vanceb/CarAudio/README.md

# CarAudio
Car Audio Using Raspberry Pi and a DAB Radio board
