vanceb/CarAudio/kicad/VolumeControl.kicad_pcb

## KiCad design kicad/VolumeControl.kicad_pcb (2016-07-01)

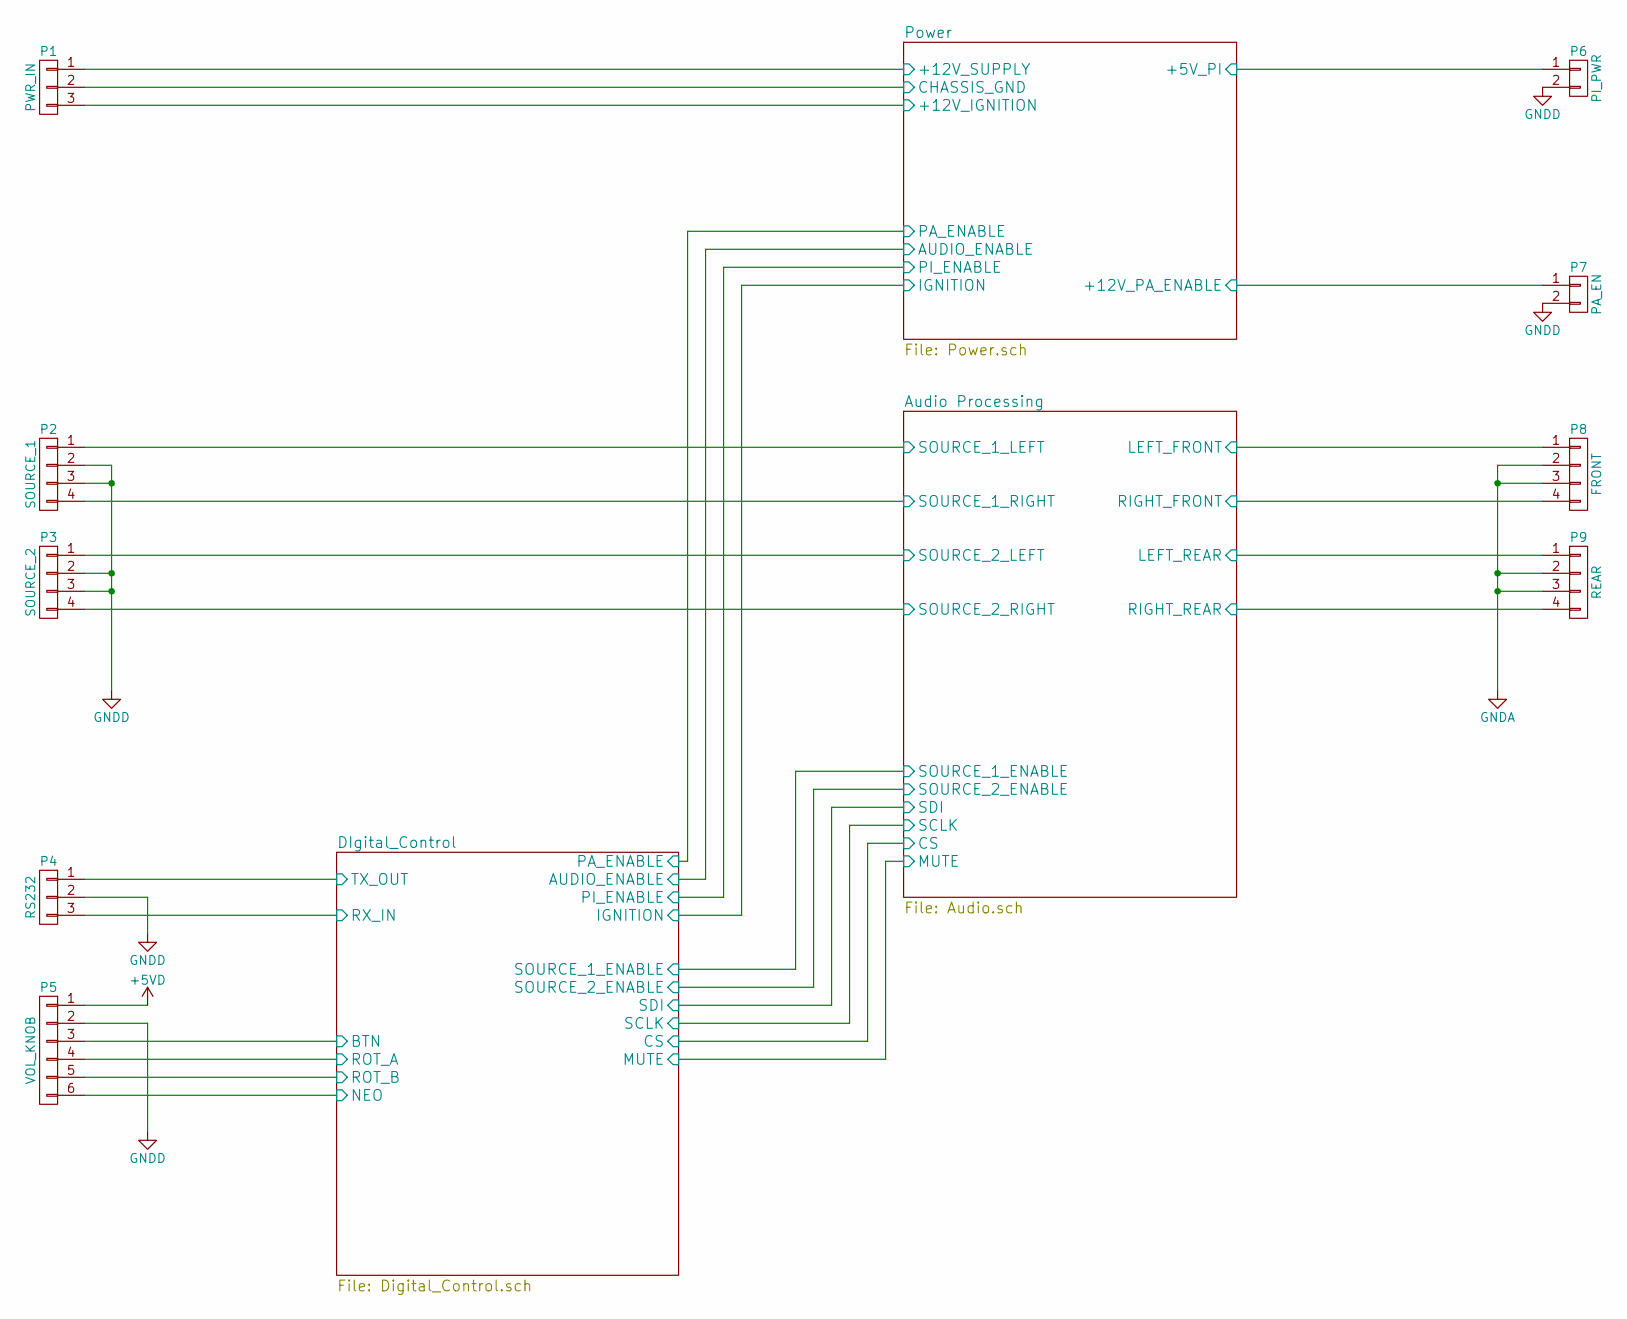
[picture p1: schematic VolumeControl.sch]

Parts:
P1: PWR_IN; JST-3RA
P2: SOURCE_1; JST-4RA
P3: SOURCE_2; JST-4RA
P4: RS232; JST-3RA
P5: VOL_KNOB; JST-6RA
P6: PI_PWR; JST-2RA
P7: PA_EN; JST-2RA
P8: FRONT; JST-4RA
P9: REAR; JST-4RA

Connections:
+5VD: P5.1; also elsewhere on the board
/Audio Processing/LEFT_FRONT: P8.1; also elsewhere on the board
/Audio Processing/LEFT_REAR: P9.1; also elsewhere on the board
/Audio Processing/RIGHT_FRONT: P8.4; also elsewhere on the board
/Audio Processing/RIGHT_REAR: P9.4; also elsewhere on the board
/Audio Processing/SOURCE_1_LEFT: P2.1; also elsewhere on the board
/Audio Processing/SOURCE_1_RIGHT: P2.4; also elsewhere on the board
/Audio Processing/SOURCE_2_LEFT: P3.1; also elsewhere on the board
/Audio Processing/SOURCE_2_RIGHT: P3.4; also elsewhere on the board
/DIgital_Control/BTN: P5.3; also elsewhere on the board
/DIgital_Control/NEO: P5.6; also elsewhere on the board
/DIgital_Control/ROT_A: P5.4; also elsewhere on the board
/DIgital_Control/ROT_B: P5.5; also elsewhere on the board
/DIgital_Control/RX_IN: P4.3; also elsewhere on the board
/DIgital_Control/TX_OUT: P4.1; also elsewhere on the board
/Power/+5V_PI: P6.1; also elsewhere on the board
/Power/+12V_IGNITION: P1.3; also elsewhere on the board
/Power/+12V_PA_ENABLE: P7.1; also elsewhere on the board
/Power/+12V_SUPPLY: P1.1; also elsewhere on the board
GND: P1.2, P2.2, P2.3, P3.2, P3.3, P4.2, P5.2, P6.2, P7.2, P8.2, P8.3, P9.2, P9.3; also elsewhere on the board

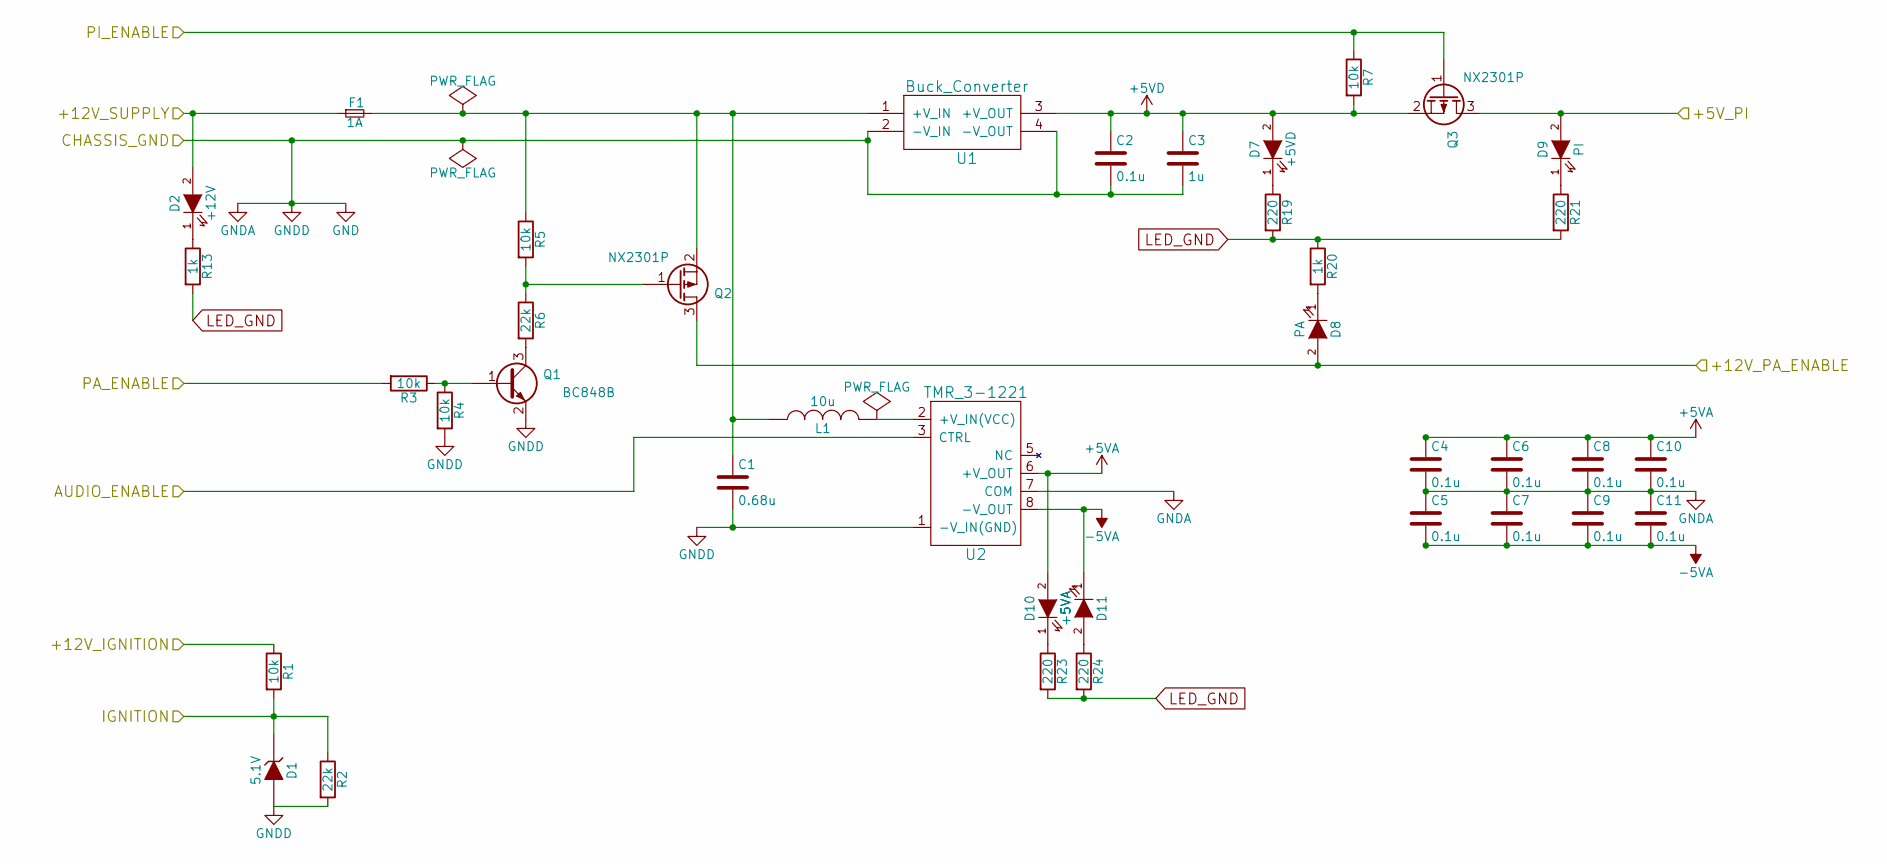
[picture p2: schematic Power.sch]

Parts:
C1: 0.68u; C_1206_HandSoldering
C2, C4, C5, C6, C7, C8, C9, C10, C11: 0.1u; C_0603_HandSoldering
C3: 1u; C_1206_HandSoldering
D1: 5.1V; SOD-123
D2: +12V; LED_SMD_1.6x0.8mm
D7: +5VD; LED_SMD_1.6x0.8mm
D8: PA; LED_SMD_1.6x0.8mm
D9: PI; LED_SMD_1.6x0.8mm
D10: +5VA; LED_SMD_1.6x0.8mm
D11: -5VA; LED_SMD_1.6x0.8mm
F1: 1A; Fuseholder5x20_horiz_SemiClosed_Casing10x25mm
L1: 10u; Inductor_SRR0735A
Q1: BC848B; SOT-23_Handsoldering
Q2, Q3: NX2301P; SOT-23_Handsoldering
R1, R3, R4, R5, R7: 10k; R_0603_HandSoldering
R2, R6: 22k; R_0603_HandSoldering
R13, R20: 1k; R_0603_HandSoldering
R19, R21, R23, R24: 220; R_0603_HandSoldering
U1: Buck_Converter
U2: TMR_3-1221; TMR_3

Connections:
+5VA: C4.1, C6.1, C8.1, C10.1, D10.2 (A), U2.6 (+V_OUT); also elsewhere on the board
+5VD: C2.1, C3.1, D7.2 (A), Q3.2 (S), R7.2, U1.3 (+V_OUT); also elsewhere on the board
-5VA: C5.2, C7.2, C9.2, C11.2, D11.1 (K), U2.8 (-V_OUT); also elsewhere on the board
/DIgital_Control/AUDIO_ENABLE: U2.3 (CTRL); also elsewhere on the board
/DIgital_Control/IGNITION: D1.1 (K), R1.2, R2.1; also elsewhere on the board
/DIgital_Control/PA_ENABLE: R3.2; also elsewhere on the board
/DIgital_Control/PI_ENABLE: Q3.1 (G), R7.1; also elsewhere on the board
/Power/+5V_PI: D9.2 (A), Q3.3 (D); also elsewhere on the board
/Power/+12V_IGNITION: R1.1; also elsewhere on the board
/Power/+12V_PA_ENABLE: D8.2 (A), Q2.3 (D); also elsewhere on the board
/Power/+12V_SUPPLY: D2.2 (A), F1.1; also elsewhere on the board
GND: C1.2, C2.2, C3.2, C4.2, C5.1, C6.2, C7.1, C8.2, C9.1, C10.2, C11.1, D1.2 (A), Q1.2 (E), R2.2, R4.2, U1.2 (-V_IN), U1.4 (-V_OUT), U2.1 (-V_IN(GND)), U2.7 (COM); also elsewhere on the board
LED_GND: R13.2, R19.2, R20.1, R21.2, R23.2, R24.2; also elsewhere on the board
unnamed: C1.1, F1.2, L1.1, Q2.2 (S), R5.1, U1.1 (+V_IN)
unnamed: D2.1 (K), R13.1
unnamed: D7.1 (K), R19.1
unnamed: D8.1 (K), R20.2
unnamed: D9.1 (K), R21.1
unnamed: D10.1 (K), R23.1
unnamed: D11.2 (A), R24.1
unnamed: L1.2, U2.2 (+V_IN(VCC))
unnamed: Q1.1 (B), R3.1, R4.1
unnamed: Q1.3 (C), R6.2
unnamed: Q2.1 (G), R5.2, R6.1

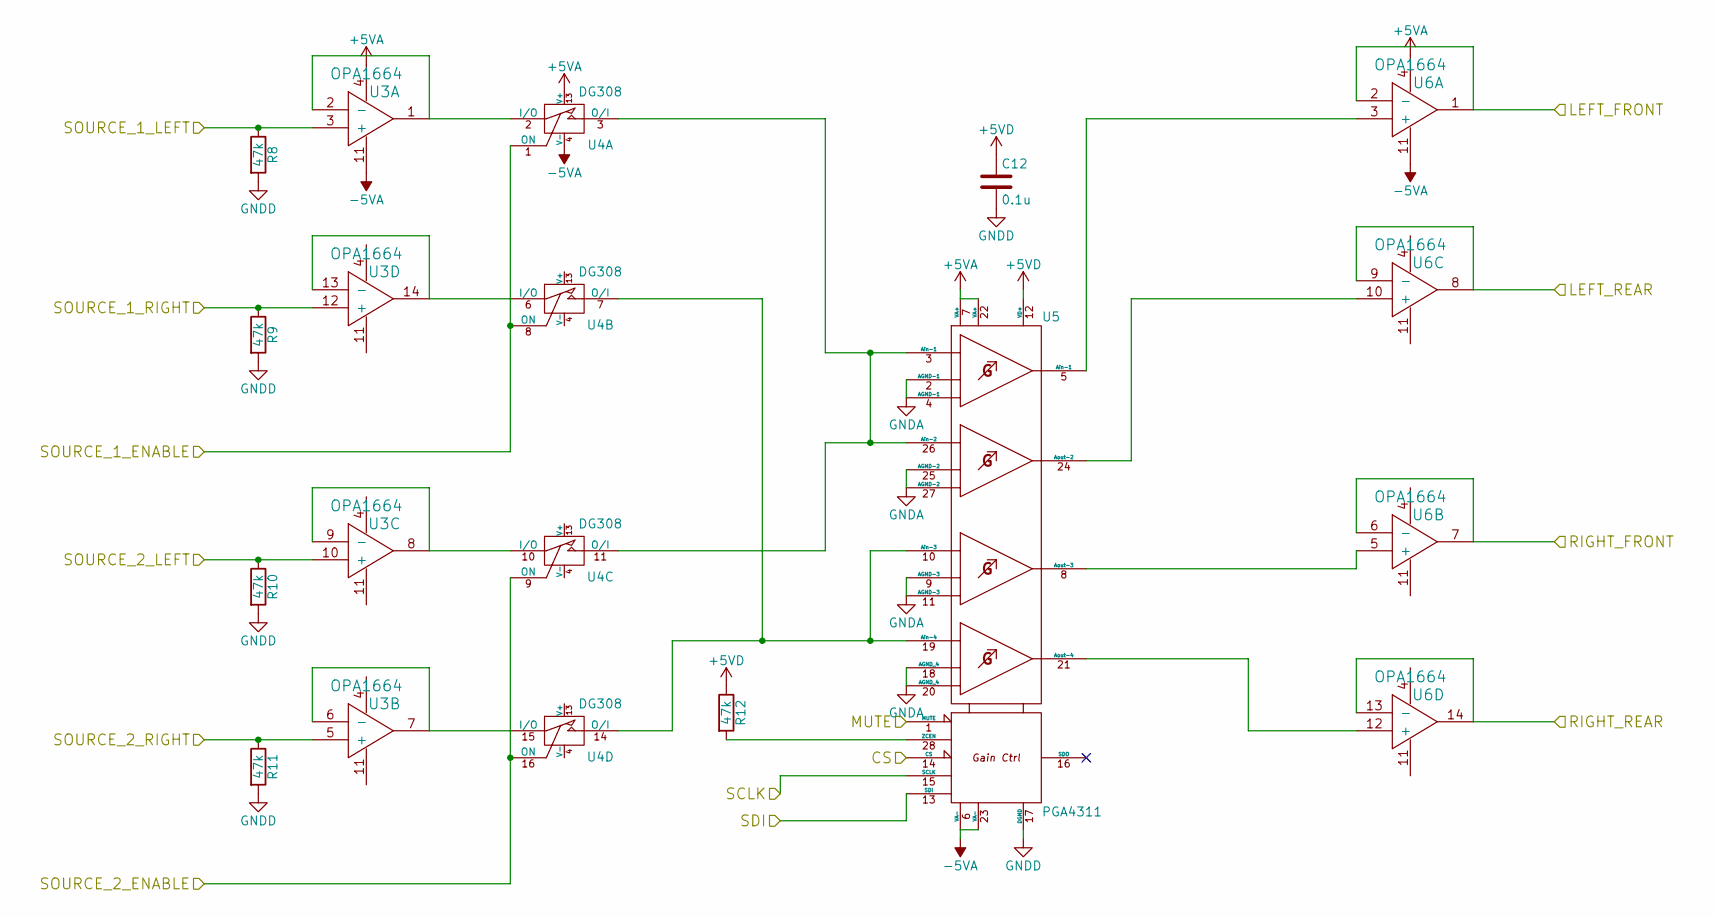
[picture p3: schematic Audio.sch]

Parts:
C12: 0.1u; C_0603_HandSoldering
R8, R9, R10, R11, R12: 47k; R_0603_HandSoldering
U3, U6: OPA1664; SOIC-14_N
U4: DG308; SOIC-16_3.9x9.9mm_Pitch1.27mm
U5: PGA4311; SOIC-28_7.5x17.9mm_Pitch1.27mm

Connections:
+5VA: U3.4, U4.13 (V+), U5.7 (VA+), U5.22 (VA+), U6.4; also elsewhere on the board
+5VD: C12.1, R12.1, U5.12 (VD+); also elsewhere on the board
-5VA: U3.11, U4.4 (V-), U5.6 (VA-), U5.23 (VA-), U6.11; also elsewhere on the board
/Audio Processing/CS: U5.14 (CS); also elsewhere on the board
/Audio Processing/LEFT_FRONT: U6.1, U6.2 (-); also elsewhere on the board
/Audio Processing/LEFT_REAR: U6.8, U6.9 (-); also elsewhere on the board
/Audio Processing/MUTE: U5.1 (MUTE); also elsewhere on the board
/Audio Processing/RIGHT_FRONT: U6.6 (-), U6.7; also elsewhere on the board
/Audio Processing/RIGHT_REAR: U6.13 (-), U6.14; also elsewhere on the board
/Audio Processing/SCLK: U5.15 (SCLK); also elsewhere on the board
/Audio Processing/SDI: U5.13 (SDI); also elsewhere on the board
/Audio Processing/SOURCE_1_ENABLE: U4.1 (ON), U4.8 (ON); also elsewhere on the board
/Audio Processing/SOURCE_1_LEFT: R8.1, U3.3 (+); also elsewhere on the board
/Audio Processing/SOURCE_1_RIGHT: R9.1, U3.12 (+); also elsewhere on the board
/Audio Processing/SOURCE_2_ENABLE: U4.9 (ON), U4.16 (ON); also elsewhere on the board
/Audio Processing/SOURCE_2_LEFT: R10.1, U3.10 (+); also elsewhere on the board
/Audio Processing/SOURCE_2_RIGHT: R11.1, U3.5 (+); also elsewhere on the board
GND: C12.2, R8.2, R9.2, R10.2, R11.2, U4.5 (GND), U5.2 (AGND-1), U5.4 (AGND-1), U5.9 (AGND-3), U5.11 (AGND-3), U5.17 (DGND), U5.18 (AGND_4), U5.20 (AGND_4), U5.25 (AGND-2), U5.27 (AGND-2); also elsewhere on the board
unnamed: R12.2, U5.28 (ZCEN)
unnamed: U3.1, U3.2 (-), U4.2 (I/O)
unnamed: U3.6 (-), U3.7, U4.15 (I/O)
unnamed: U3.8, U3.9 (-), U4.10 (I/O)
unnamed: U3.13 (-), U3.14, U4.6 (I/O)
unnamed: U4.3 (O/I), U4.11 (O/I), U5.3 (Ain-1), U5.26 (Ain-2)
unnamed: U4.7 (O/I), U4.14 (O/I), U5.10 (Ain-3), U5.19 (Ain-4)
unnamed: U5.5 (Ain-1), U6.3 (+)
unnamed: U5.8 (Aout-3), U6.5 (+)
unnamed: U5.21 (Aout-4), U6.12 (+)
unnamed: U5.24 (Aout-2), U6.10 (+)

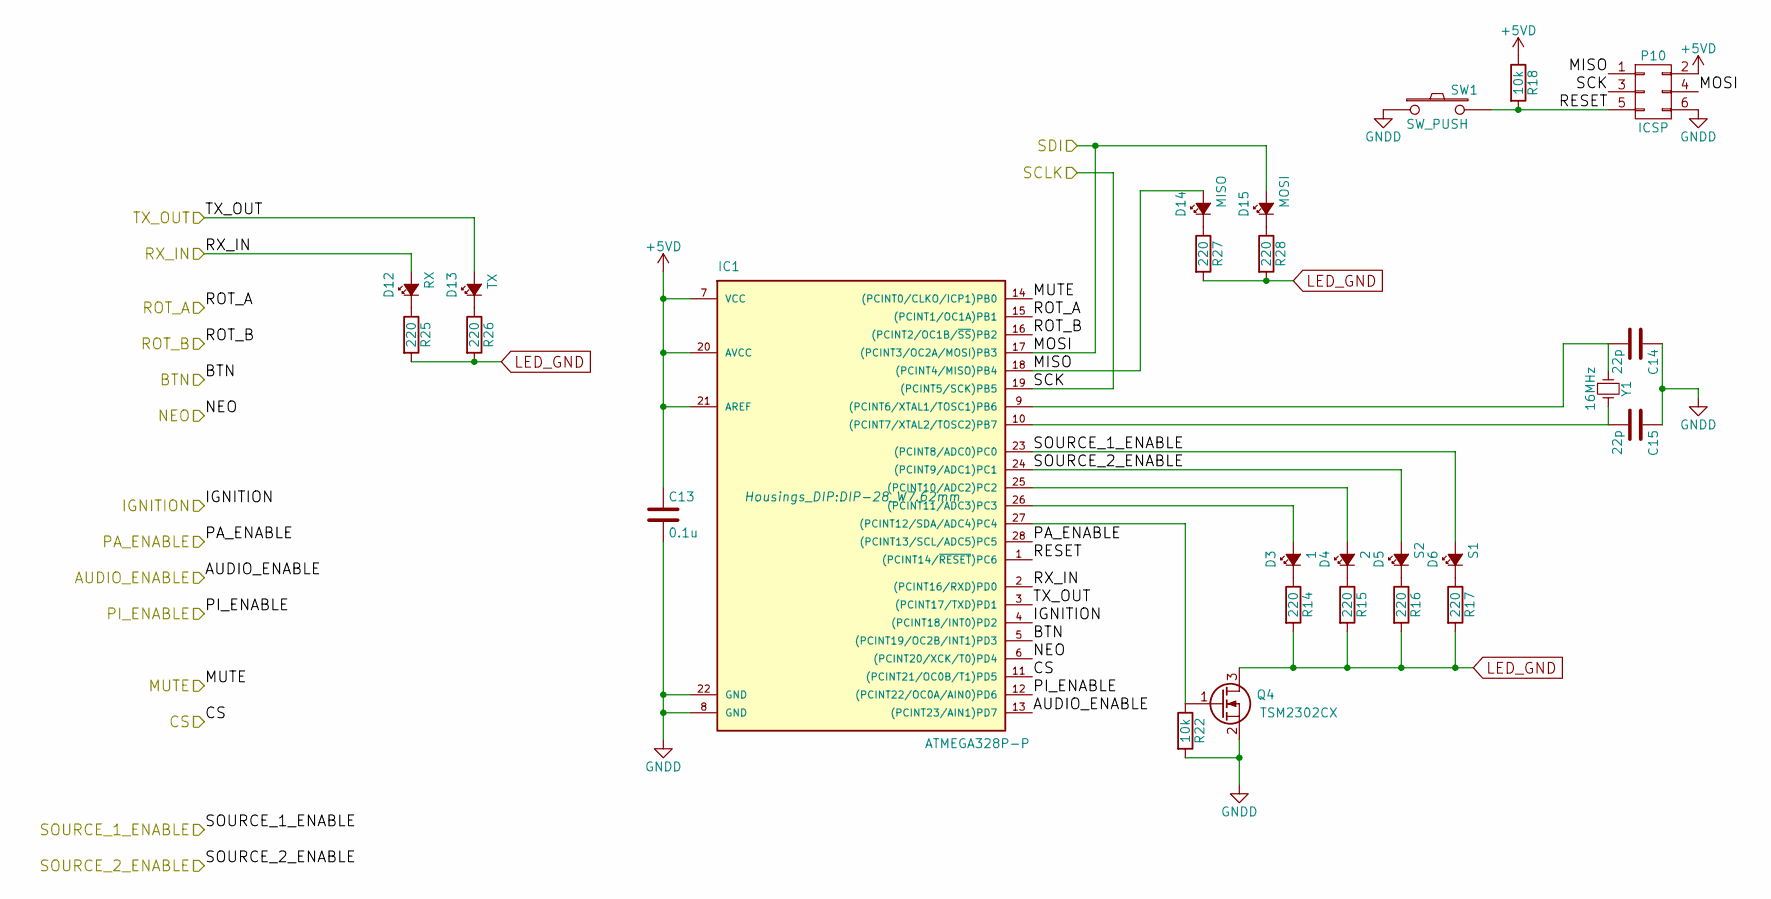
[picture p4: schematic Digital_Control.sch]

Parts:
C13: 0.1u; C_0603_HandSoldering
C14, C15: 22p; C_0603_HandSoldering
D3: 1; LED_SMD_1.6x0.8mm
D4: 2; LED_SMD_1.6x0.8mm
D5: S2; LED_SMD_1.6x0.8mm
D6: S1; LED_SMD_1.6x0.8mm
D12: RX; LED_SMD_1.6x0.8mm
D13: TX; LED_SMD_1.6x0.8mm
D14: MISO; LED_SMD_1.6x0.8mm
D15: MOSI; LED_SMD_1.6x0.8mm
IC1: ATMEGA328P-P; DIP-28_W7.62mm
P10: ICSP; Pin_Header_Straight_2x03
Q4: TSM2302CX; SOT-23_Handsoldering
R14, R15, R16, R17, R25, R26, R27, R28: 220; R_0603_HandSoldering
R18, R22: 10k; R_0603_HandSoldering
SW1: SW_PUSH; SW_SPST_EVPBF
Y1: 16MHz; Crystal_HC49-U_Vertical

Connections:
+5VD: C13.1, IC1.7 (VCC), IC1.20 (AVCC), IC1.21 (AREF), P10.2, R18.1; also elsewhere on the board
/Audio Processing/CS: IC1.11 ((PCINT21/OC0B/T1)PD5); also elsewhere on the board
/Audio Processing/MUTE: IC1.14 ((PCINT0/CLKO/ICP1)PB0); also elsewhere on the board
/Audio Processing/SCLK: IC1.19 ((PCINT5/SCK)PB5), P10.3; also elsewhere on the board
/Audio Processing/SDI: D15.2 (A), IC1.17 ((PCINT3/OC2A/MOSI)PB3), P10.4; also elsewhere on the board
/Audio Processing/SOURCE_1_ENABLE: D6.2 (A), IC1.23 ((PCINT8/ADC0)PC0); also elsewhere on the board
/Audio Processing/SOURCE_2_ENABLE: D5.2 (A), IC1.24 ((PCINT9/ADC1)PC1); also elsewhere on the board
/DIgital_Control/AUDIO_ENABLE: IC1.13 ((PCINT23/AIN1)PD7); also elsewhere on the board
/DIgital_Control/BTN: IC1.5 ((PCINT19/OC2B/INT1)PD3); also elsewhere on the board
/DIgital_Control/IGNITION: IC1.4 ((PCINT18/INT0)PD2); also elsewhere on the board
/DIgital_Control/MISO: D14.2 (A), IC1.18 ((PCINT4/MISO)PB4), P10.1
/DIgital_Control/NEO: IC1.6 ((PCINT20/XCK/T0)PD4); also elsewhere on the board
/DIgital_Control/PA_ENABLE: IC1.28 ((PCINT13/SCL/ADC5)PC5); also elsewhere on the board
/DIgital_Control/PI_ENABLE: IC1.12 ((PCINT22/OC0A/AIN0)PD6); also elsewhere on the board
/DIgital_Control/RESET: IC1.1 ((PCINT14/~RESET~)PC6), P10.5, R18.2, SW1.2
/DIgital_Control/ROT_A: IC1.15 ((PCINT1/OC1A)PB1); also elsewhere on the board
/DIgital_Control/ROT_B: IC1.16 ((PCINT2/OC1B/~SS~)PB2); also elsewhere on the board
/DIgital_Control/RX_IN: D12.2 (A), IC1.2 ((PCINT16/RXD)PD0); also elsewhere on the board
/DIgital_Control/TX_OUT: D13.2 (A), IC1.3 ((PCINT17/TXD)PD1); also elsewhere on the board
GND: C13.2, C14.1, C15.1, IC1.8 (GND), IC1.22 (GND), P10.6, Q4.2 (S), R22.2, SW1.1; also elsewhere on the board
LED_GND: Q4.3 (D), R14.2, R15.2, R16.2, R17.2, R25.2, R26.2, R27.2, R28.2; also elsewhere on the board
unnamed: C14.2, IC1.9 ((PCINT6/XTAL1/TOSC1)PB6), Y1.1
unnamed: C15.2, IC1.10 ((PCINT7/XTAL2/TOSC2)PB7), Y1.2
unnamed: D3.1 (K), R14.1
unnamed: D3.2 (A), IC1.26 ((PCINT11/ADC3)PC3)
unnamed: D4.1 (K), R15.1
unnamed: D4.2 (A), IC1.25 ((PCINT10/ADC2)PC2)
unnamed: D5.1 (K), R16.1
unnamed: D6.1 (K), R17.1
unnamed: D12.1 (K), R25.1
unnamed: D13.1 (K), R26.1
unnamed: D14.1 (K), R27.1
unnamed: D15.1 (K), R28.1
unnamed: IC1.27 ((PCINT12/SDA/ADC4)PC4), Q4.1 (G), R22.1

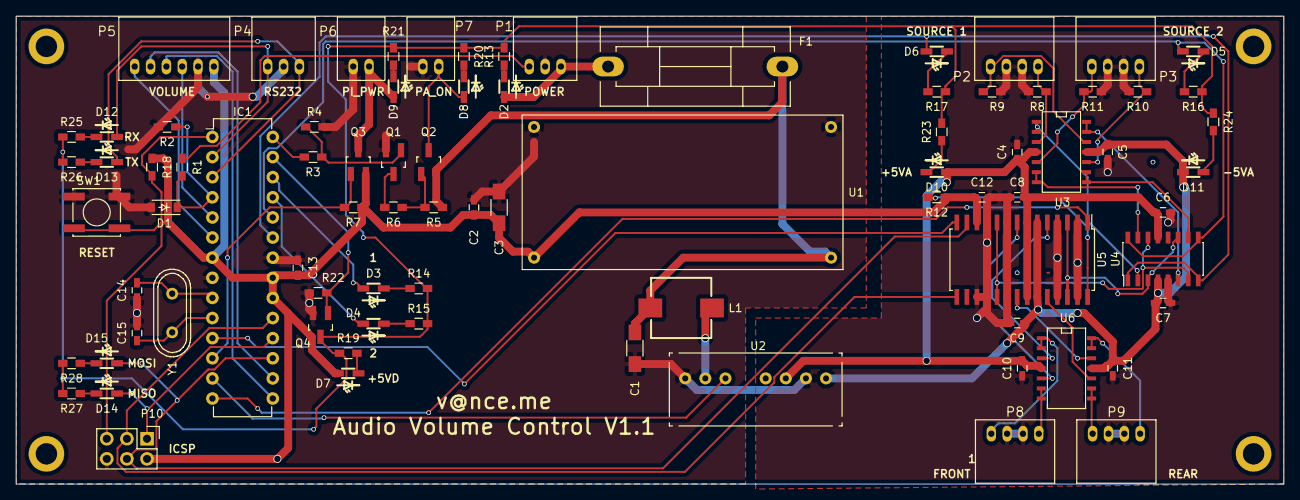
[picture p5: board VolumeControl.kicad_pcb from above]

Board: 2 copper layers, 160.0 x 59.1 mm, 83 parts (0 on the bottom side), 70 nets.
