vanceb/CarAudio/kicad/VolKnob/VolKnob.kicad_pcb

## KiCad design kicad/VolKnob/VolKnob.kicad_pcb (2016-06-23)

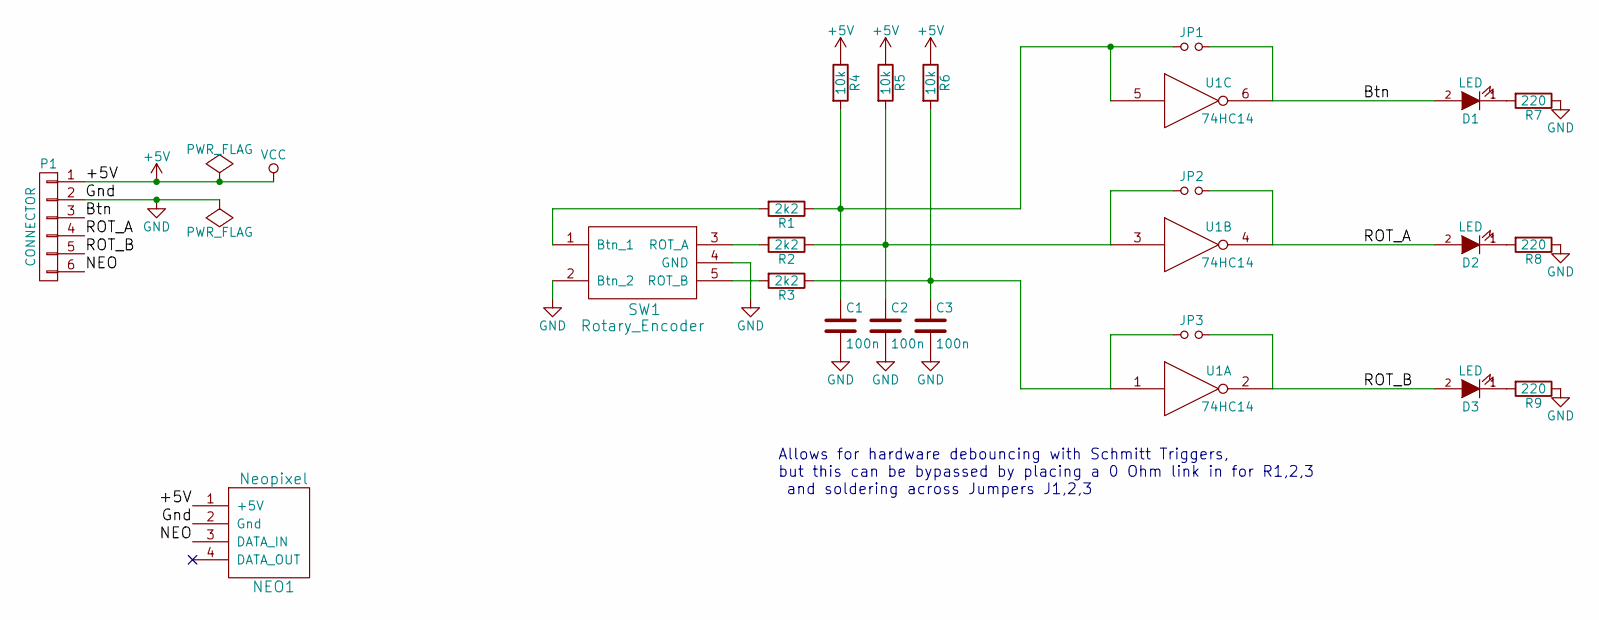
[picture p6: schematic VolKnob.sch]

Parts:
C1, C2, C3: 100n; C_0603_HandSoldering
D1, D2, D3: LED; LED_SMD_1.6x0.8mm
JP1, JP2, JP3: Jumper_NO_Small; Jumper_NO
NEO1: Neopixel; NeoPixel_Ring_12
P1: CONNECTOR; JST-6RA
R1, R2, R3: 2k2; R_0603_HandSoldering
R4, R5, R6: 10k; R_0603_HandSoldering
R7, R8, R9: 220; R_0603_HandSoldering
SW1: Rotary_Encoder
U1: 74HC14; SOIC-14_N

Connections:
+5V: NEO1.1 (+5V), P1.1, R4.1, R5.1, R6.1, U1.14 (VCC)
/Btn: D1.2 (A), JP1.2, P1.3, U1.6
/NEO: NEO1.3 (DATA_IN), P1.6
/ROT_A: D2.2 (A), JP2.2, P1.4, U1.4
/ROT_B: D3.2 (A), JP3.2, P1.5, U1.2
GND: C1.2, C2.2, C3.2, NEO1.2 (Gnd), P1.2, R7.1, R8.1, R9.1, SW1.2 (Btn_2), SW1.4 (GND), U1.7 (GND)
unnamed: C1.1, JP1.1, R1.1, R4.2, U1.5
unnamed: C2.1, JP2.1, R2.1, R5.2, U1.3
unnamed: C3.1, JP3.1, R3.1, R6.2, U1.1
unnamed: D1.1 (K), R7.2
unnamed: D2.1 (K), R8.2
unnamed: D3.1 (K), R9.2
unnamed: R1.2, SW1.1 (Btn_1)
unnamed: R2.2, SW1.3 (ROT_A)
unnamed: R3.2, SW1.5 (ROT_B)

Notes on the sheet:
Allows for hardware debouncing with Schmitt Triggers, but this can be bypassed by placing a 0 Ohm link in for R1,2,3 and soldering across Jumpers J1,2,3

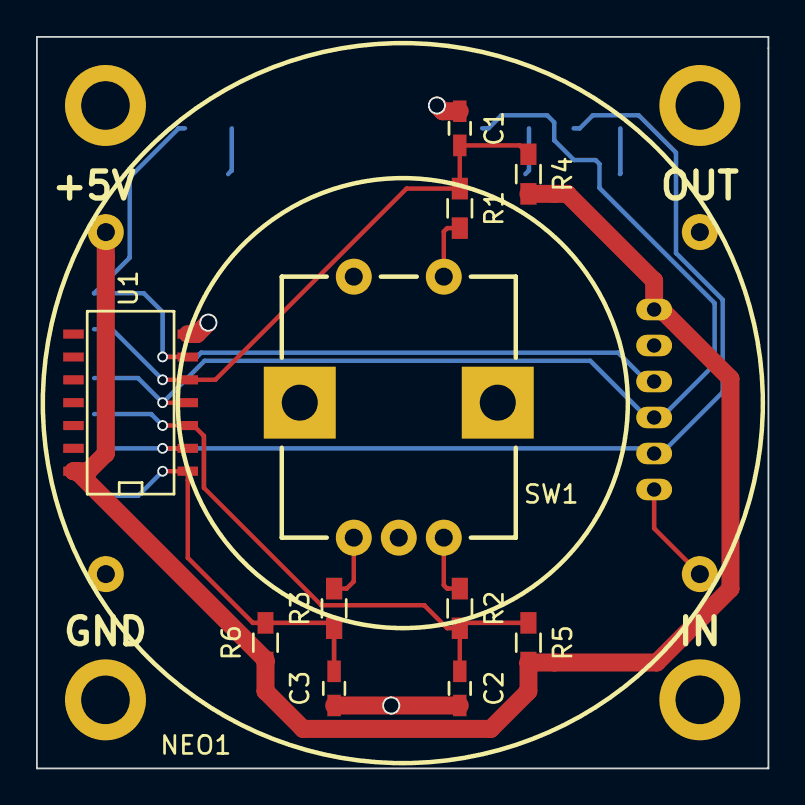
[picture p7: board VolKnob.kicad_pcb from above]

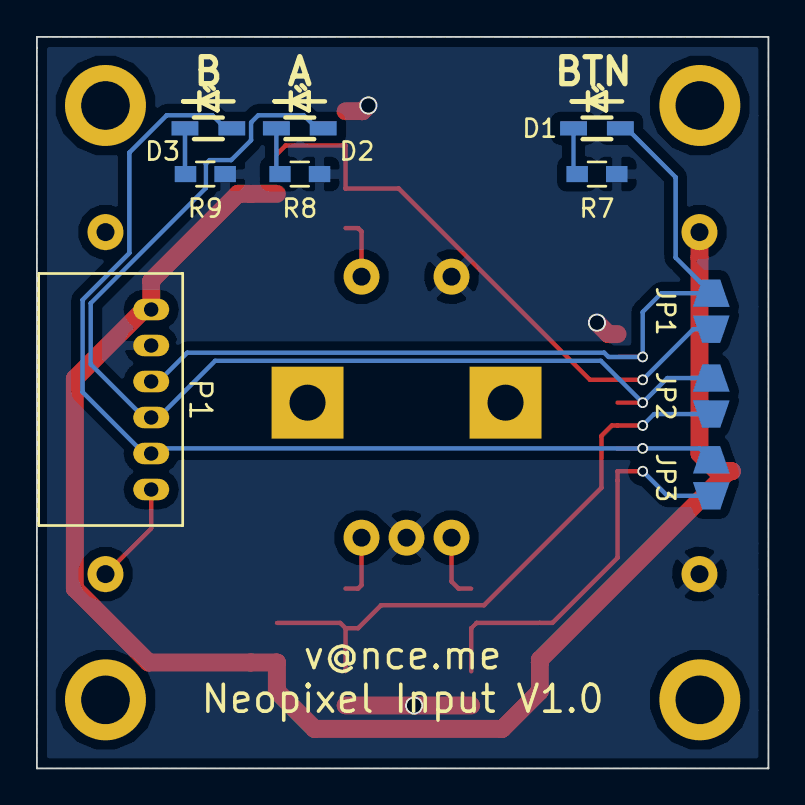
[picture p8: board VolKnob.kicad_pcb from below]

Board: 2 copper layers, 40.6 x 40.6 mm, 22 parts (10 on the bottom side), 15 nets.
