vanceb/CarAudio/kicad/20160330_VolumeControl.kicad_pcb

## KiCad design kicad/20160330_VolumeControl.kicad_pcb (2016-05-11)

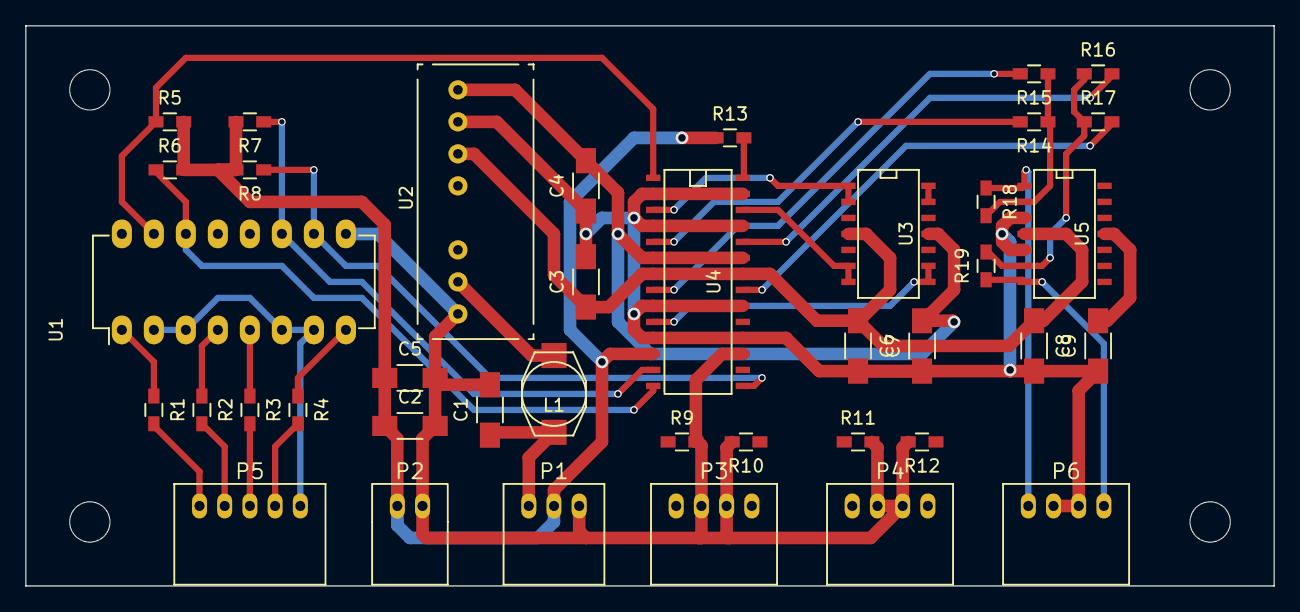
[picture p9: board 20160330_VolumeControl.kicad_pcb from above]

Board: 2 copper layers, 99.1 x 44.5 mm, 40 parts (0 on the bottom side), 37 nets.

Parts:
C1: 0.68u; C_1206_HandSoldering
C2, C3, C4, C6, C7, C8, C9: 0.1u; C_1206_HandSoldering
C5: 1u; C_1206_HandSoldering
L1: 10u; SELF-WE-PD3S
P1: PWR_IN; JST-3RA
P2: PWR_OUT; JST-2RA
P3: SOURCE_1; JST-4RA
P4: SOURCE_2; JST-4RA
P5: CONTROL; JST-5RA
P6: AUDIO_OUT; JST-4RA
R1, R2, R3, R4: 200; R_0603_HandSoldering
R5, R6, R7, R8, R9, R10, R11, R12, R13, R14, R15, R16, R17, R18, R19: 47k; R_0603_HandSoldering
U1: ILQ74; DIP-16_W7.62mm_LongPads
U2: TMR_3-1221; TMR_3
U3, U5: OPA1664; SOIC-14_N
U4: PGA4311; SOIC-28

Connections:
+5VA: C3.1, C6.1, C8.1, U2.6, U3.4, U4.7, U4.22, U5.4
+5VD: C2.1, C5.1, P1.2, P2.1, R5.2, R6.2, R7.2, R8.2, R13.1, U4.12
+12V: C1.1, L1.1, P1.1
-5VA: C4.2, C7.2, C9.2, U2.8, U3.11, U4.6, U4.23, U5.11
/Audio Processing/CS_ISOLATED: R6.1, U1.14, U4.14
/Audio Processing/LEFT: P6.1, R18.1, U5.1
/Audio Processing/MUTE_ISOLATED: R5.1, U1.15, U4.1
/Audio Processing/RIGHT: P6.4, R19.1, U5.7
/Audio Processing/SCL_ISOLATED: R8.1, U1.10, U4.15
/Audio Processing/SDA_ISOLATED: R7.1, U1.11, U4.13
/Audio Processing/SOURCE_1_LEFT: P3.1, R9.1, U3.3
/Audio Processing/SOURCE_1_RIGHT: P3.4, R10.1, U3.5
/Audio Processing/SOURCE_2_LEFT: P4.1, R11.1, U3.10
/Audio Processing/SOURCE_2_RIGHT: P4.4, R12.1, U3.12
/Digital Control/CS: P5.2, R2.2
/Digital Control/CTRL_GND: P5.5, U1.2, U1.3, U1.6, U1.7
/Digital Control/MUTE: P5.1, R1.2
/Digital Control/SCL: P5.4, R4.2
/Digital Control/SDA: P5.3, R3.2
GNDA: C3.2, C4.1, C6.2, C7.1, C8.2, C9.1, P6.2, P6.3, U2.7, U4.2, U4.4, U4.9, U4.11, U4.18, U4.20, U4.25, U4.27, U5.3, U5.5
GNDD: C1.2, C2.2, C5.2, P1.3, P2.2, P3.2, P3.3, P4.2, P4.3, R9.2, R10.2, R11.2, R12.2, U1.9, U1.12, U1.13, U1.16, U2.1, U4.17
unnamed: L1.2, U2.2
unnamed: R1.1, U1.1
unnamed: R2.1, U1.4
unnamed: R3.1, U1.5
unnamed: R4.1, U1.8
unnamed: R13.2, U4.28
unnamed: R14.1, R15.1, R18.2, U5.2
unnamed: R14.2, U4.5
unnamed: R15.2, U4.8
unnamed: R16.1, R17.1, R19.2, U5.6
unnamed: R16.2, U4.24
unnamed: R17.2, U4.21
unnamed: U3.1, U3.2, U4.3
unnamed: U3.6, U3.7, U4.26
unnamed: U3.8, U3.9, U4.10
unnamed: U3.13, U3.14, U4.19
