vanceb/CarAudio/(commit log)

2016-02-23 Initial Audio Board Design in Kicad, still WIP
    [Audio.sch, DigitalControl.sch, Power.sch, VolumeControl.kicad_pcb, VolumeControl.sch]
2016-05-11 Adding untracked files
    [20160330_VolumeControl.kicad_pcb, Audio.sch, DigitalControl.sch, Power.sch, VolumeControl.kicad_pcb, VolumeControl.sch]
2016-05-11 Removed extra directory needed for Arduino IDE to revert to Platformio project
2016-06-12 First working version of using a timer to debounce the rotary encoder
2016-06-12 Created Rotary Encoder with Neopixel ring PCB for Volume control
    [VolKnob.kicad_pcb, VolKnob.sch, _saved_VolKnob.sch]
2016-06-13 Modified circuit to allow for hardware debounce
    [VolKnob.kicad_pcb, VolKnob.sch, _saved_VolKnob.sch]
2016-06-14 Reworked schematics to allow control of the power and introduction of ATMega328P for control
    [Audio.sch, Digital_Control.sch, Power.sch, VolumeControl.sch]
2016-06-15 Produced Volume knob including Gerbers, and updated main board to remove ERC errors. Just about to start board layout
    [Audio.sch, Digital_Control.sch, Power.sch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]
2016-06-15 Routed the board. Passes ERC check
    [Audio.sch, Digital_Control.sch, Power.sch, VolumeControl.kicad_pcb]
2016-06-15 Minor change
    [VolumeControl.kicad_pcb]
2016-06-15 Gerber files created
    [VolumeControl-B.Cu.gbl, VolumeControl-B.Mask.gbs, VolumeControl-B.SilkS.gbo, VolumeControl-Edge.Cuts.gm1, VolumeControl-F.Cu.gtl, VolumeControl-F.Mask.gts, VolumeControl-F.SilkS.gto, VolumeControl-NPTH.drl]
2016-06-15 Slightly tweaked silkscreen and regenerated gerbers
    [VolumeControl.kicad_pcb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]
2016-06-16 Updated to include extra indicator LEDs controlled by the ATMega. PCB reworked
    [Digital_Control.sch, Power.sch, VolumeControl.kicad_pcb]
2016-06-23 Minor updates and board submitted for fabrication
    [Digital_Control.sch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]
2016-06-23 basic board tests
2016-07-01 Updated board design with some footprint changes and improved audio layout
    [Audio.sch, Digital_Control.sch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]
2016-07-13 Slightly modified to include powering on and off the audio power
2016-08-18 Initial working state machine for powering on and off the device and internal compoents
2016-08-18 Changed to bitbanging SPI as I have pin conflicts on the board
2016-08-19 Updated to allow changing sources and muting via the control knob. Also introduced ability to start without ignition being on. System will come up for an hour before shutting down again, unless ignit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
    [caraudio.ino]
